yasir159/Robotic-Gripper/CAD Files/Arm Links.SLDPRT

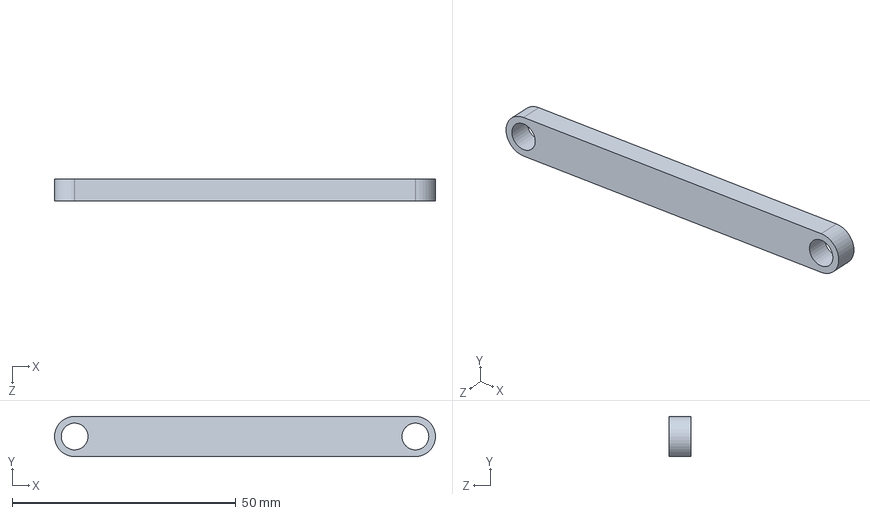
[picture p20: CAD file, 2026-06-26]
CAD Files/Arm Links.SLDPRT
85.2 x 9.00 x 5.00 mm
