yasir159/Robotic-Gripper/CAD Files/Gripper.SLDPRT

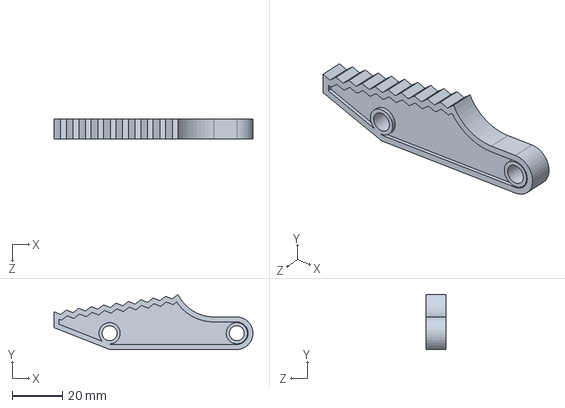
[picture p21: CAD file, 2026-06-26]
CAD Files/Gripper.SLDPRT
79.5 x 22.0 x 8.00 mm
