yasir159/Robotic-Gripper/CAD Files/Base plate1.SLDPRT

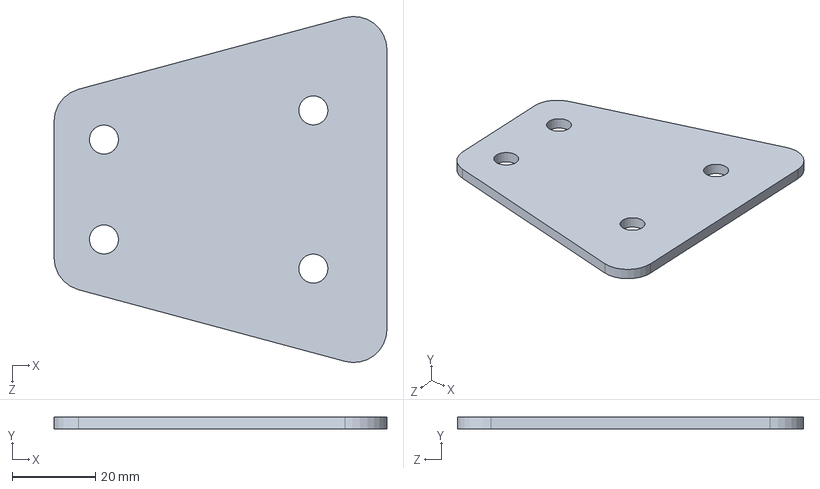
[picture p22: CAD file, 2026-06-26]
CAD Files/Base plate1.SLDPRT
80.0 x 3.00 x 83.1 mm
