yasir159/Robotic-Gripper/CAD Files/FULL_assembly.SLDASM

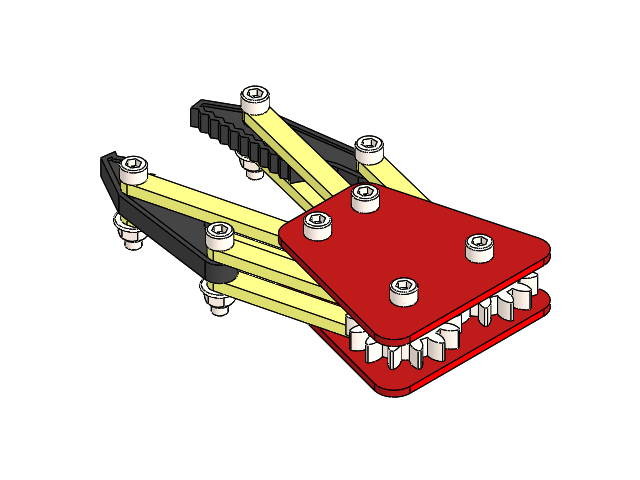
[picture p23: CAD file, 2026-06-26]
CAD Files/FULL_assembly.SLDASM
Base plate1 x 2
Gripper x 2
Arm Links x 8
socket head cap screw_am x 8
prevailing torque hex flange nut_am x 8
spur gear_am x 2
