yasir159/Robotic-Gripper/(list of files, cad)

Other CAD files:
CAD Files/Base plate2.SLDPRT
